iotool/laser-engraver/model-gcode/readme.md

# Model GCode

## Bilderrahmen Square von Depot

* 170x170mm-226x226px-round-corner-20mm.nc
* https://www.depot-online.de/de/p/bilderrahmen-square-22782
