iotool/laser-engraver/stencil/readme.md

# stencil font for laser cut

How to create a template for the Mini Laser Engraver.

## True Type Font

A special stencil font is required for cutting out the letters and numbers.
With a stencil font, all elements remain connected to the overall model via small bridges.

You can find free fonts on the Internet by searching for "free stencil font":
https://www.1001fonts.com/stenciled-fonts.html?page=3&items=10

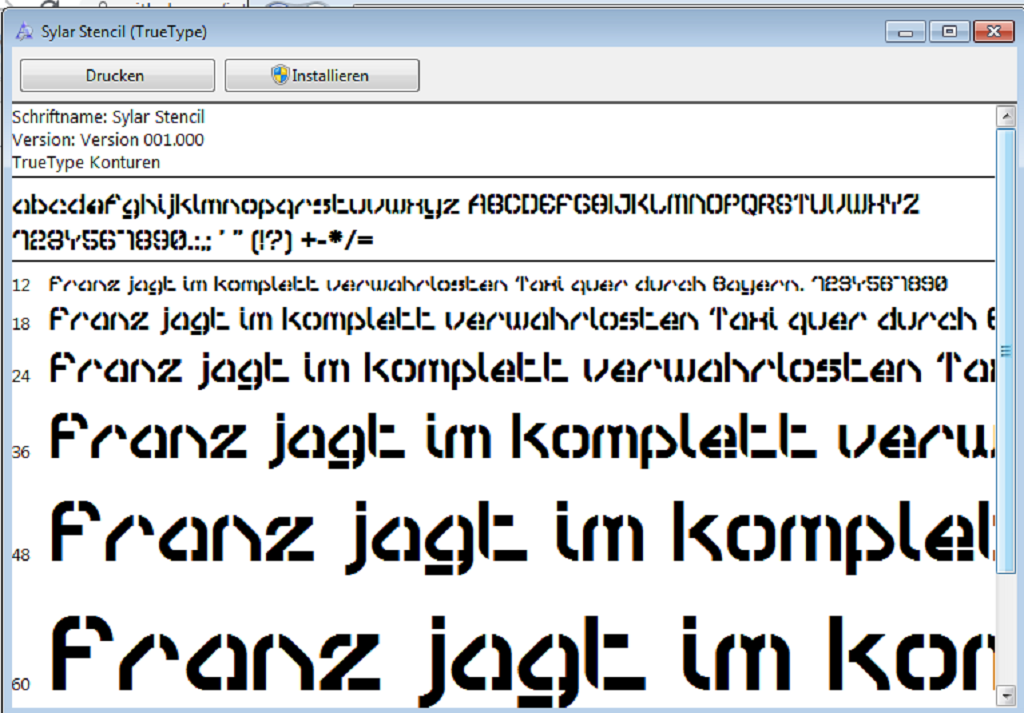
[picture p1: stencil/howto-0-stencil-font.png]
StencilFont


## Create 2D model

Only the outer edges may be cut for the Laser Cutter.
OpenSCAD can be used to determine the outer edges of text and graphics. 

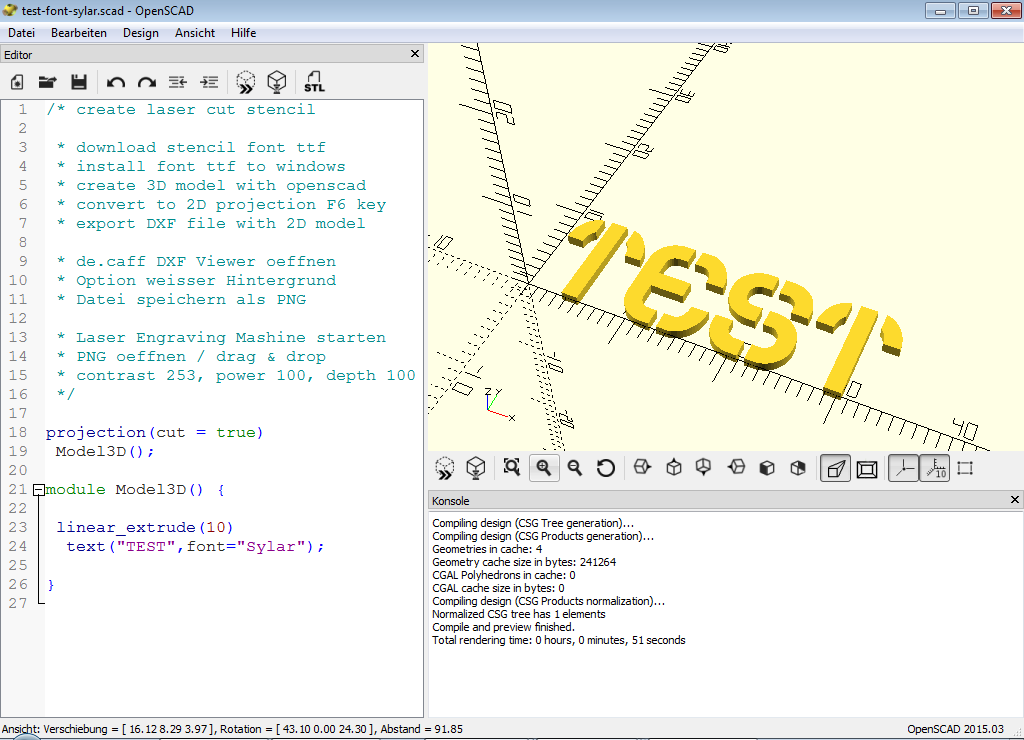
[picture p2: stencil/howto-1-openscad-3d.png]
OpenSCAD-3D


The result is exported in DXF file format.

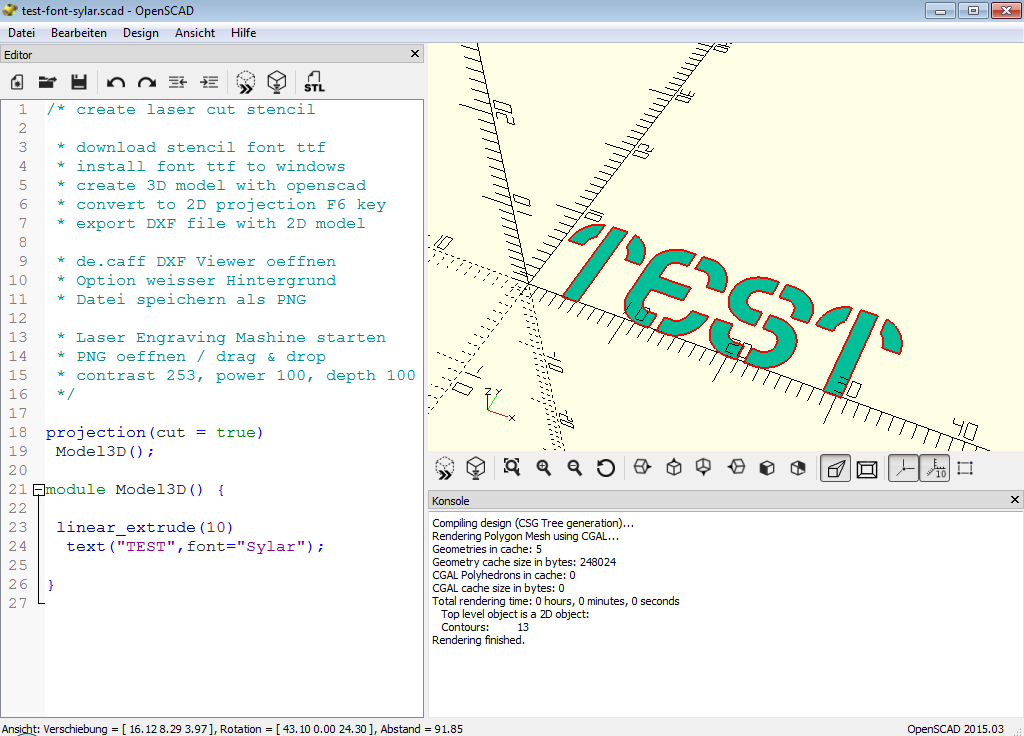
[picture p3: stencil/howto-2-openscad-2d.png]
OpenSCAD-2D


## Convert DXF to PNG

The DXF format describes the outer edges for the Laser Cutter.
For the cheap Laser Engraver DXF must be converted to PNG.

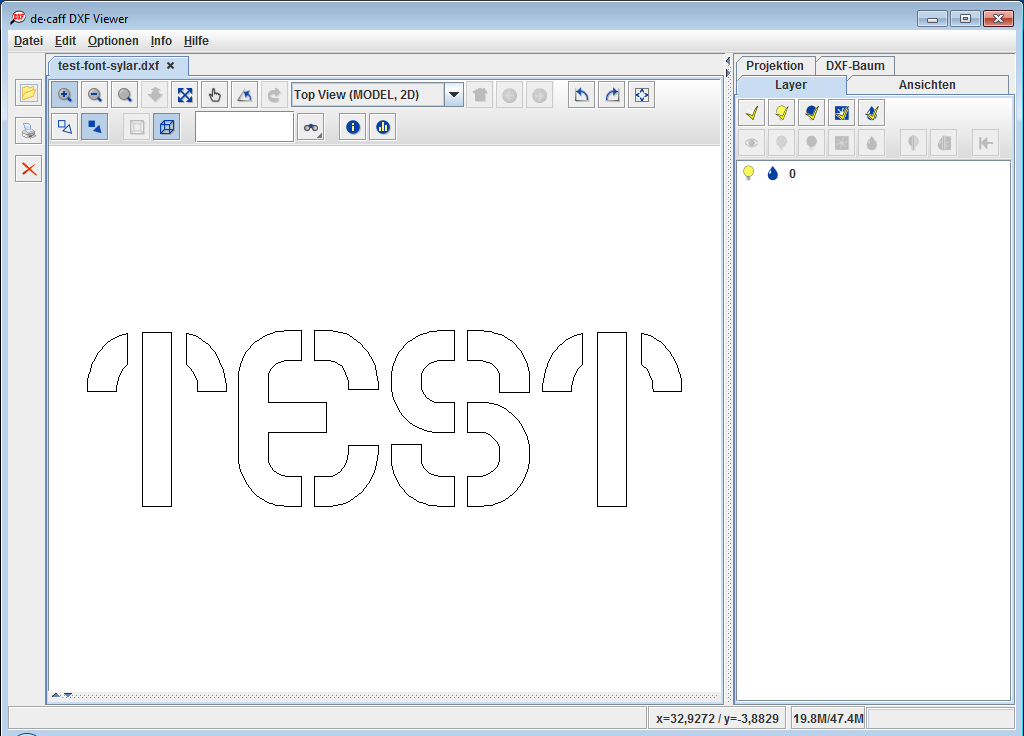
[picture p4: stencil/howto-3-decaff-dxfviewer.png]
DXF-Viewer


## Laser cut

Cutting from paper or foam rubber requires maximum power and contrast.

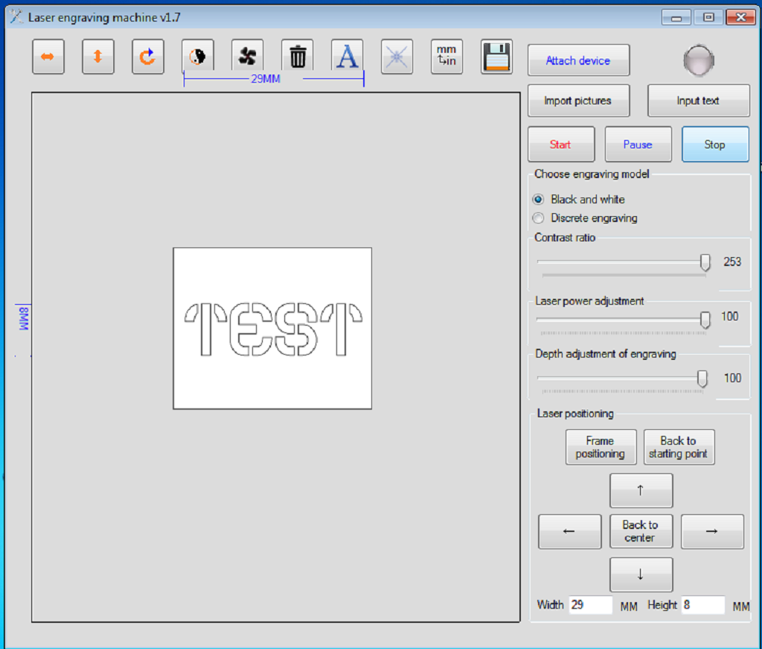
[picture p5: stencil/howto-4-laser-engraving-mashine.png]
LaserCut

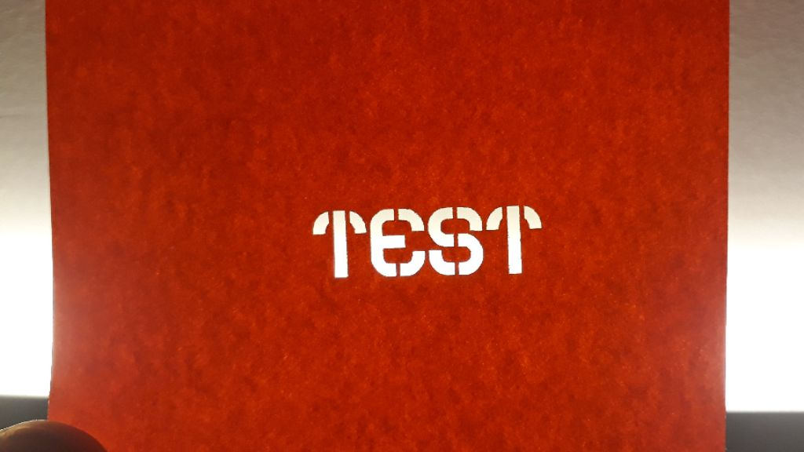
[picture p6: stencil/howto-5-stencil-paper.jpg]
StencilPaper


## Stencil Fonts

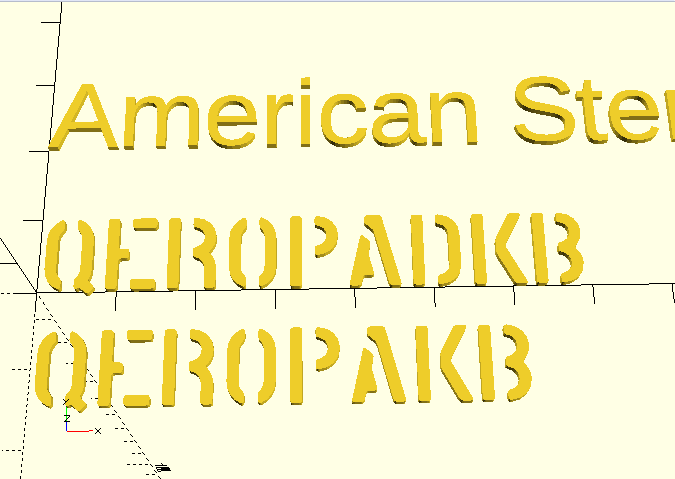
[picture p7: stencil/font-americanstencil.png]

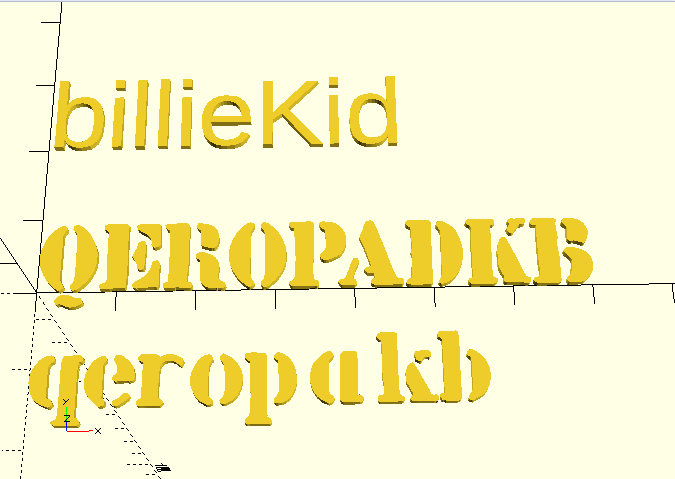
[picture p8: stencil/font-billiekid.png]

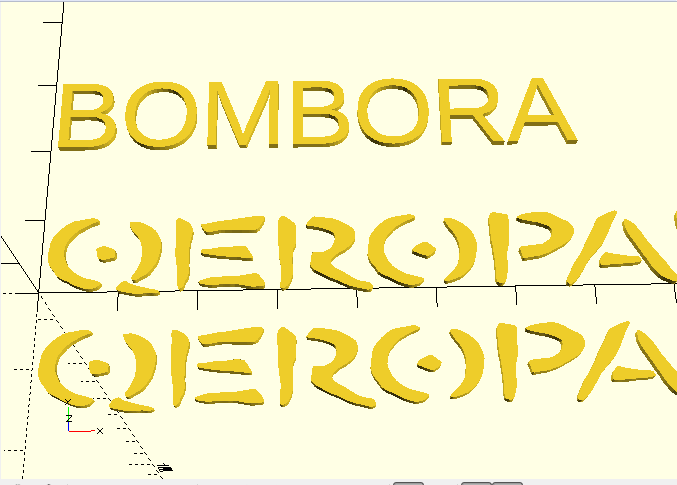
[picture p9: stencil/font-bombora.png]

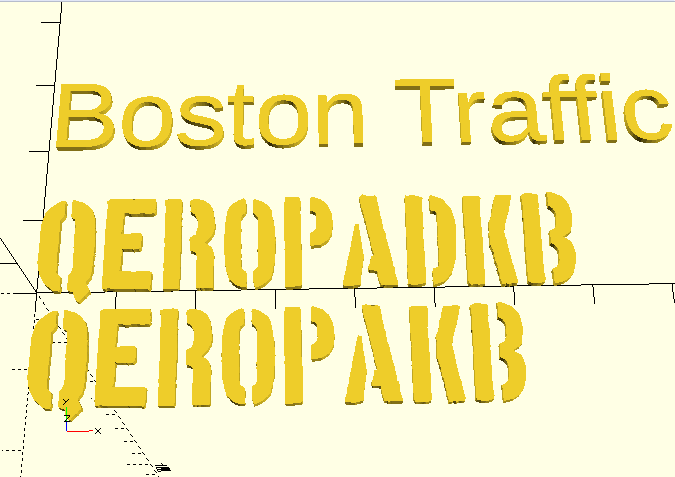
[picture p10: stencil/font-bostontraffic.png]

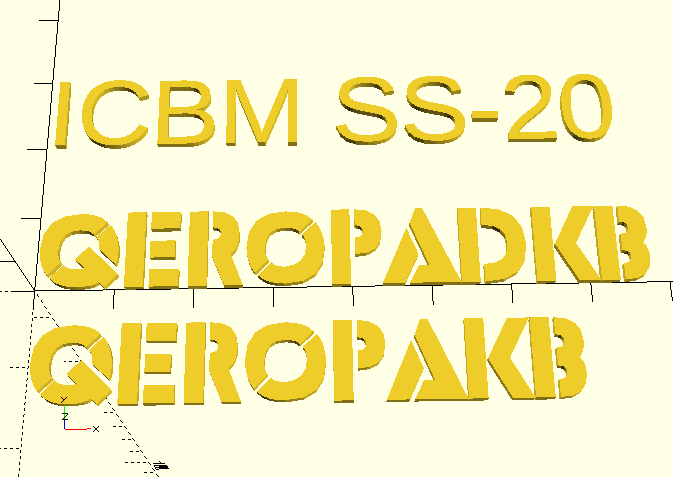
[picture p11: stencil/font-icbmss20.png]

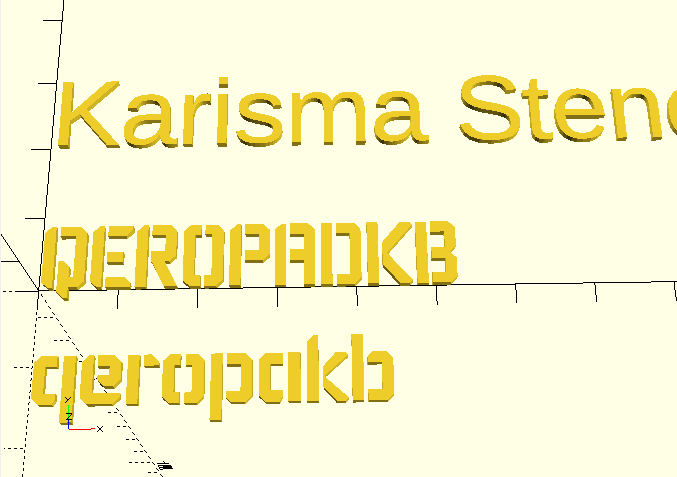
[picture p12: stencil/font-karismastencil.png]

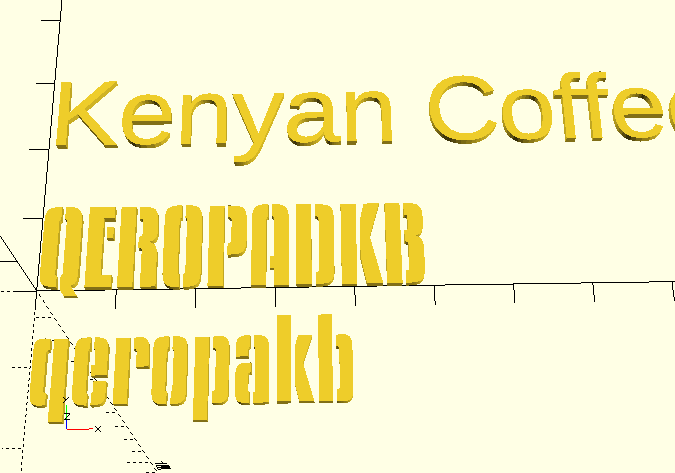
[picture p13: stencil/font-kenyancoffee.png]

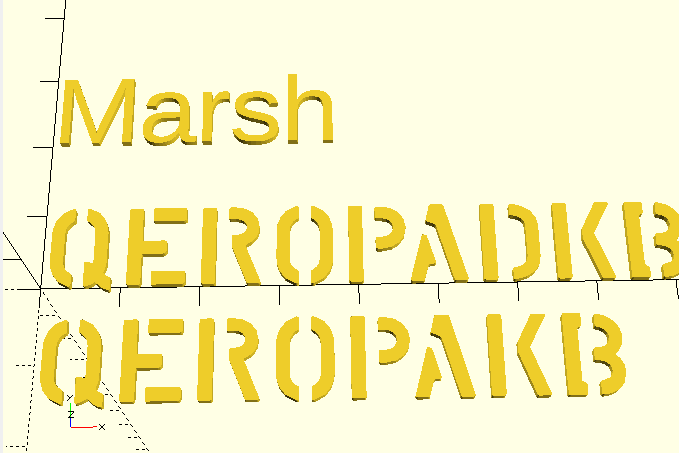
[picture p14: stencil/font-marsh.png]

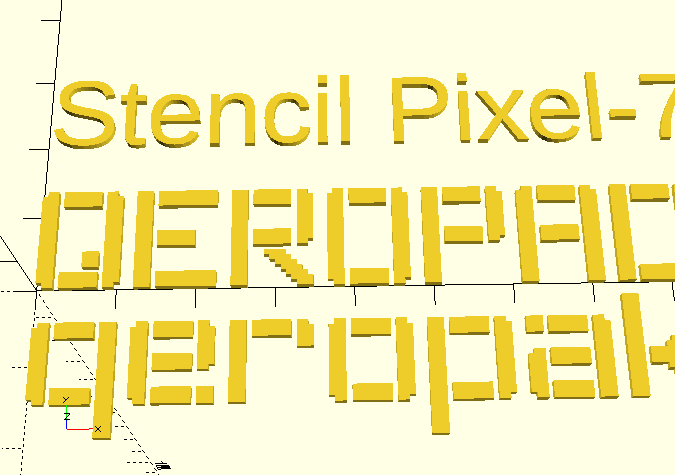
[picture p15: stencil/font-pixel7.png]

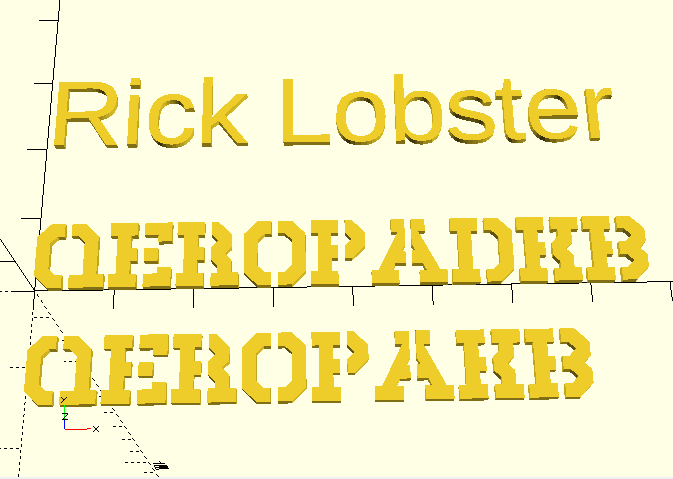
[picture p16: stencil/font-ricklobster.png]

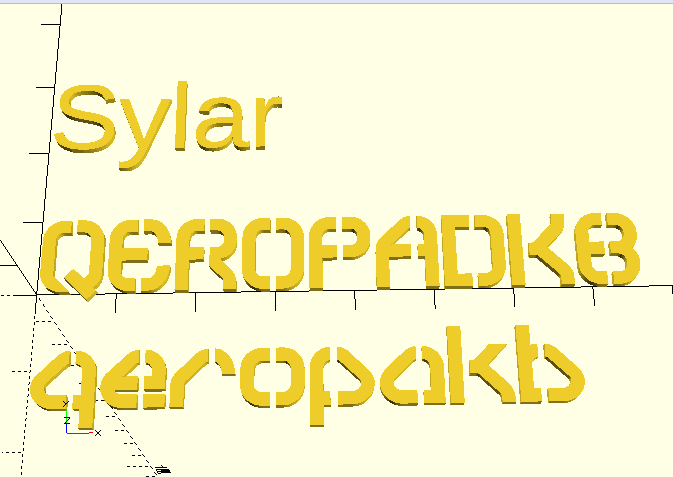
[picture p17: stencil/font-sylar.png]

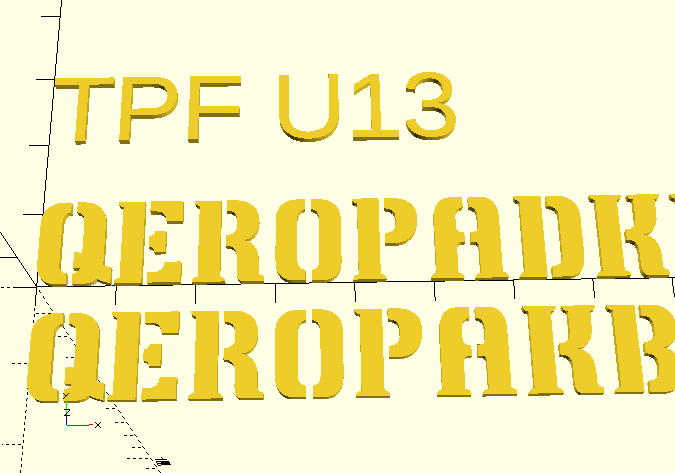
[picture p18: stencil/font-tpfu13.png]

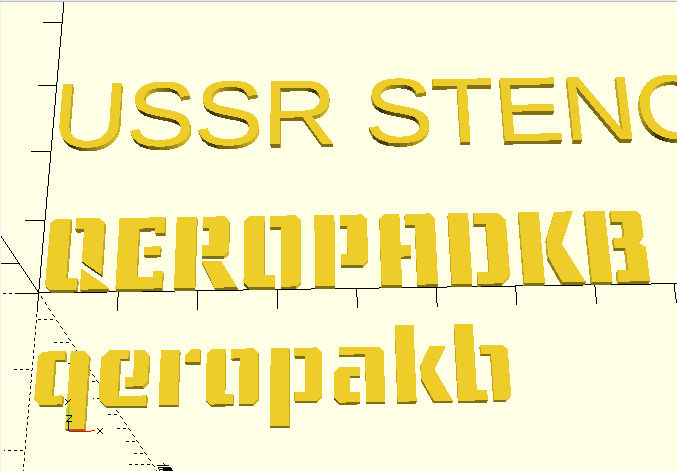
[picture p19: stencil/font-ussrstencil.png]

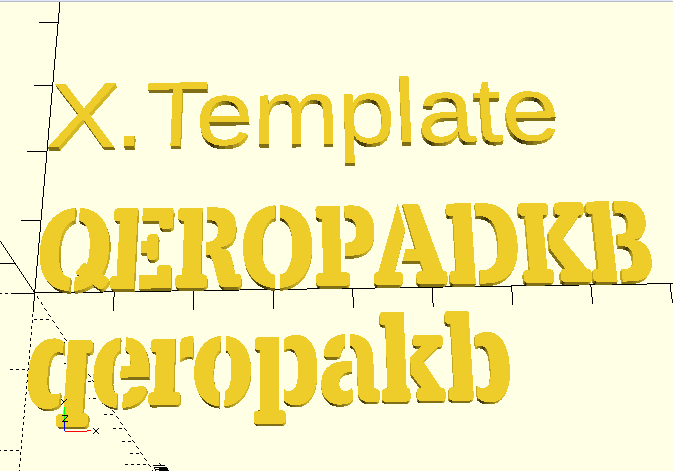
[picture p20: stencil/font-xtemplate.png]
