iotool/laser-engraver/neje-master-2/inkscape092-plugin-gcode/readme.md

# Inkscape 0.92 GCode Plugin (Laserengraver)

* copy to InkscapePortable0924\App\Inkscape\share\extensions
* create path > path from object or bitmap
* extension > laserengraver > laser
* save as c:\output\lasercut.nc

## Lasertools (linear infill)

Based on https://github.com/ChrisWag91/Inkscape-Lasertools-Plugin

This extension can generate CNC code for filled areas. This only works for paths with lines and not for curves.

Workaround for text:

* create text object
* path > object to path
* object > ungroup
* optional: path > simplify
* extension > modify path > flatten bezier (10)
* extension > lasertools > lasertools (0,2mm)

A good way to test the NC GCode is the CAMotics software.
