iotool/laser-engraver/neje-master-2/fan-holder/NejeMaster2-FanHolder-135x55mm.pdf

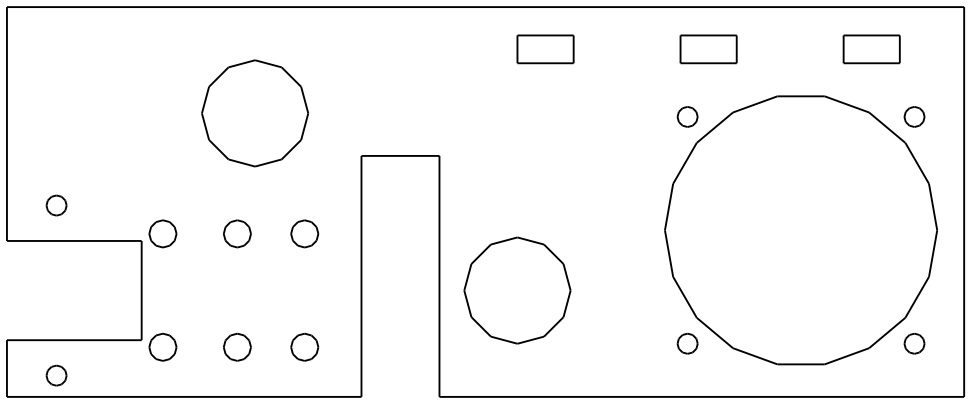
[picture p28: figure]

(0.0; 0.0; 0.0)
