iotool/laser-engraver/neje-master-2/fan-holder/NejeMaster2-FanHolder-135x50mm.pdf

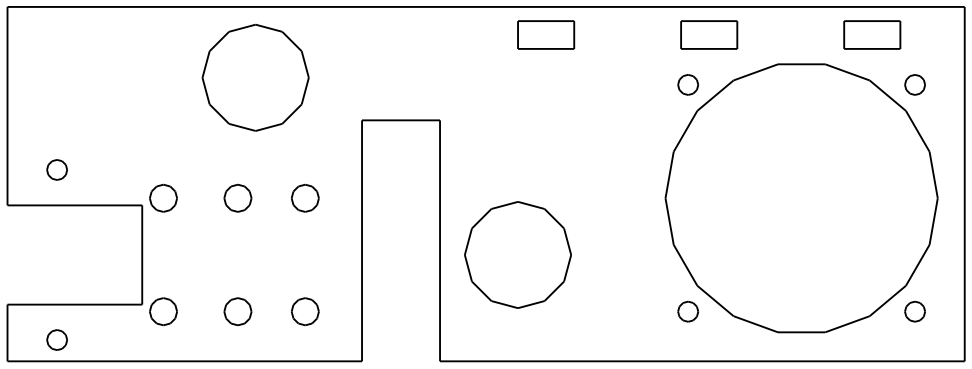
[picture p29: figure]
