iotool/laser-engraver/model-gcode/frame-170x170mm-226x226px-round-corner-20mm.png

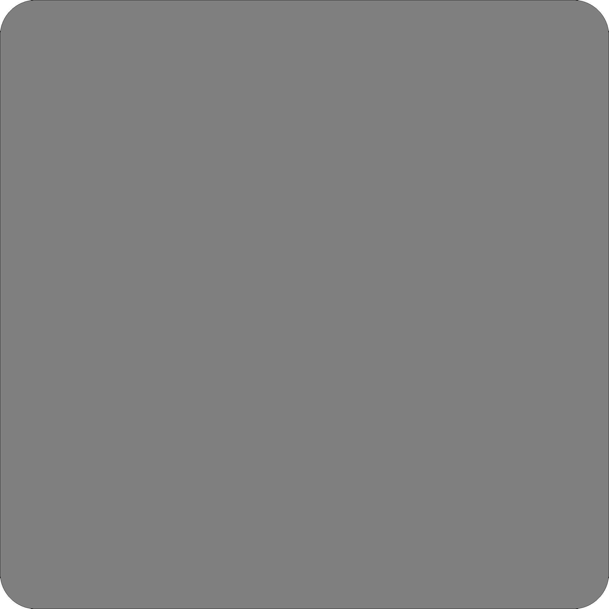
model-gcode/frame-170x170mm-226x226px-round-corner-20mm.png
