iotool/laser-engraver/neje-master-2/fan-holder/NejeMaster2-FanHolder-135x55mm.png

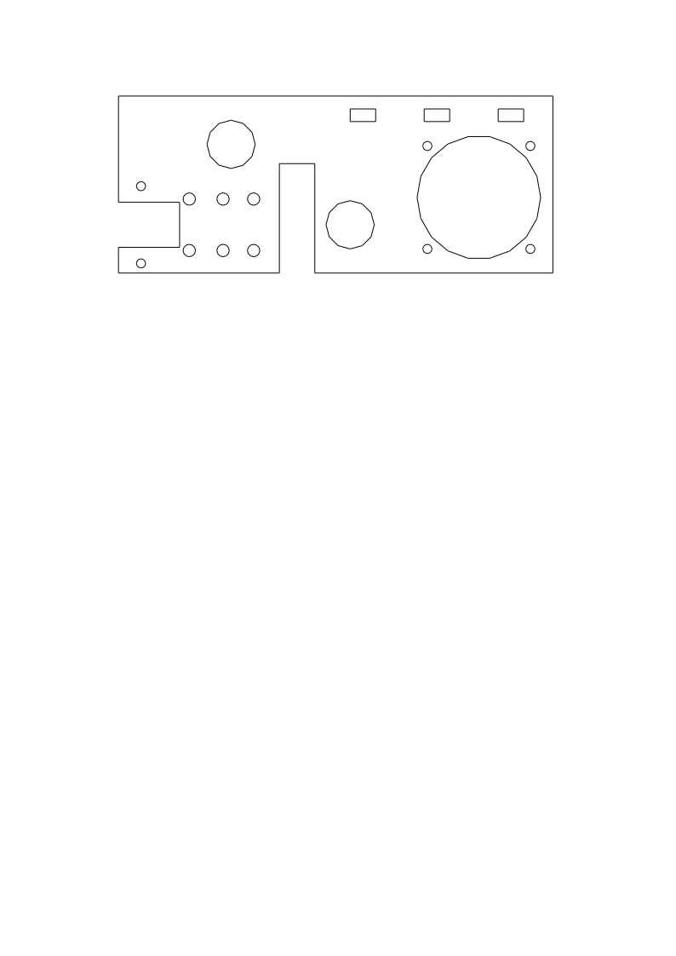
neje-master-2/fan-holder/NejeMaster2-FanHolder-135x55mm.png
