iotool/laser-engraver/model-scad/lasercut-boxes/lasercut-boxes-3mm-inside-147x123mm.dxf

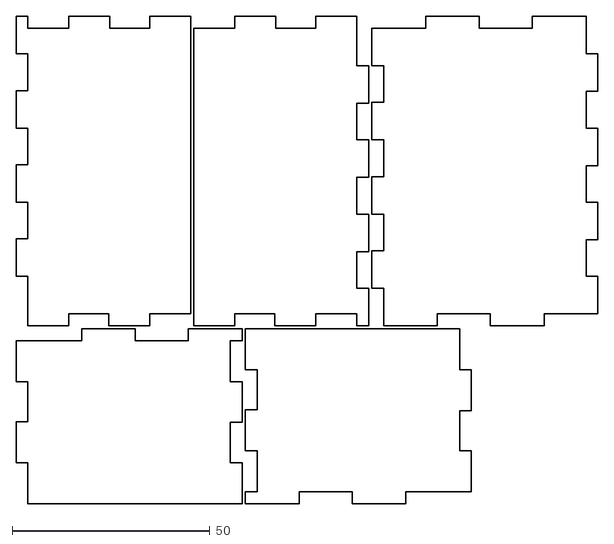
[picture p33: CAD file, 2020-11-06]
model-scad/lasercut-boxes/lasercut-boxes-3mm-inside-147x123mm.dxf
147.2 x 123.2
