iotool/laser-engraver/neje-master-2/fan-holder/NejeMaster2-FanHolder.stl

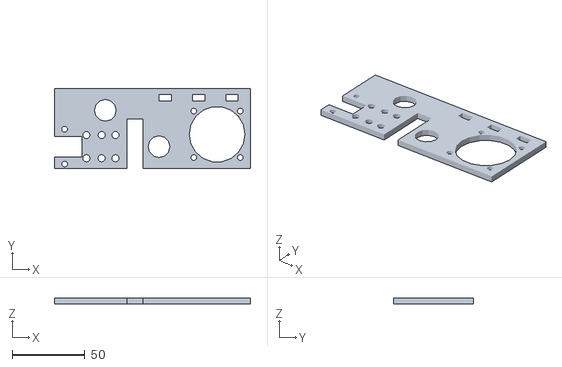
[picture p34: CAD file, 2020-10-24]
neje-master-2/fan-holder/NejeMaster2-FanHolder.stl
135.0 x 55.0 x 4.00
