iotool/laser-engraver/neje-master-2/test/test-speed-125x125mm.dxf

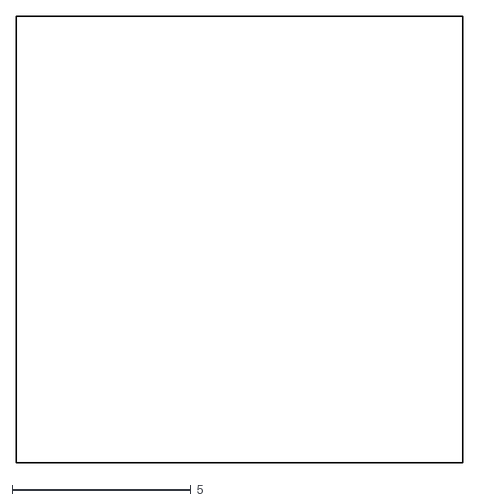
[picture p35: CAD file, 2020-10-25]
neje-master-2/test/test-speed-125x125mm.dxf
12.5 x 12.5
