iotool/laser-engraver/model-scad/lasercut-boxes/lasercut-boxes-3mm-outside-158x165mm.dxf

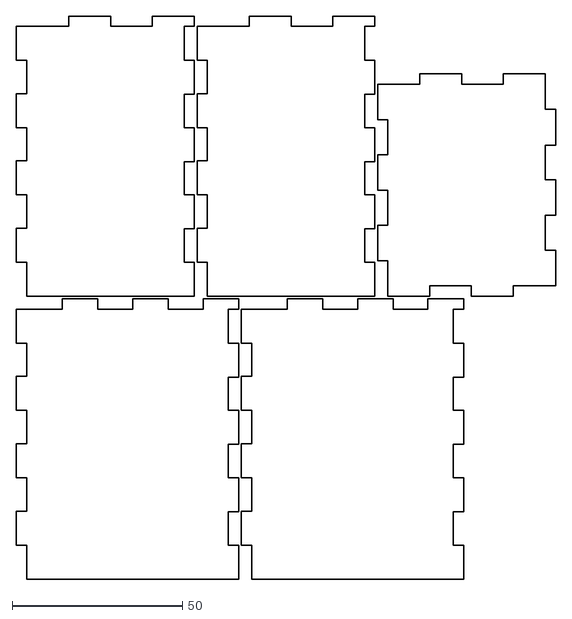
[picture p36: CAD file, 2020-11-06]
model-scad/lasercut-boxes/lasercut-boxes-3mm-outside-158x165mm.dxf
158.2 x 165.2
