iotool/laser-engraver/model-scad/lasercut-boxes/lasercut-boxes-4mm-inside-147x123mm.dxf

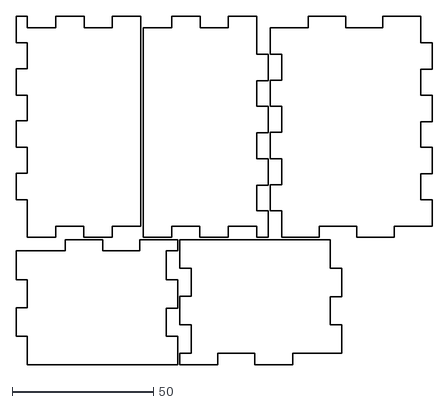
[picture p37: CAD file, 2020-11-06]
model-scad/lasercut-boxes/lasercut-boxes-4mm-inside-147x123mm.dxf
147.2 x 123.2
