iotool/laser-engraver/model-scad/lasercut-boxes/lasercut-boxes-4mm-outside-164x167mm.dxf

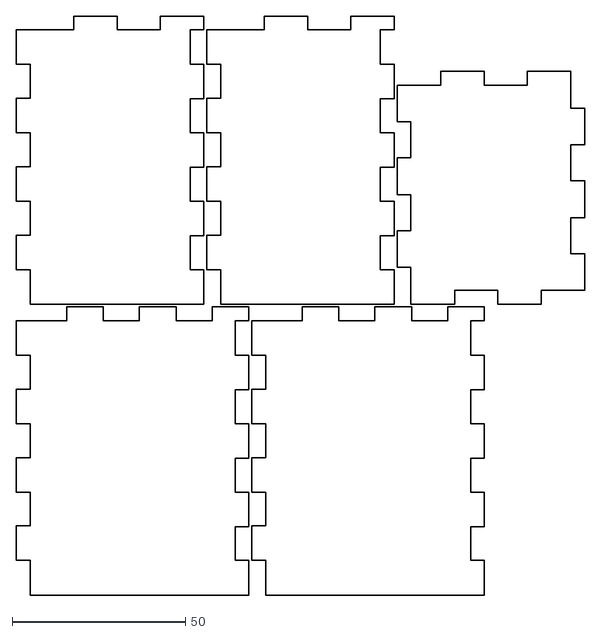
[picture p38: CAD file, 2020-11-06]
model-scad/lasercut-boxes/lasercut-boxes-4mm-outside-164x167mm.dxf
164.2 x 167.2
