iotool/laser-engraver/neje-master-2/test/test-speed-125x125mm.scad

projection()
cube([12.5,12.5,1]);
