iotool/laser-engraver/(list of files, cad)

Other CAD files:
stencil/stencil-test-font-sylar.dxf
model-scad/lasercut-util/lasercut-util.scad
neje-master-2/fan-holder/NejeMaster2-FanHolder.dxf
