iotool/laser-engraver/neje-master-2/test/readme.md

# NEJE Master 2

* Size max. 170 x 170 mm 
* Image max. 2266 x 2266 px
* 338 dpi (133.3 px/cm)
* reduce smoky smell with coffee powder

## Speed Test

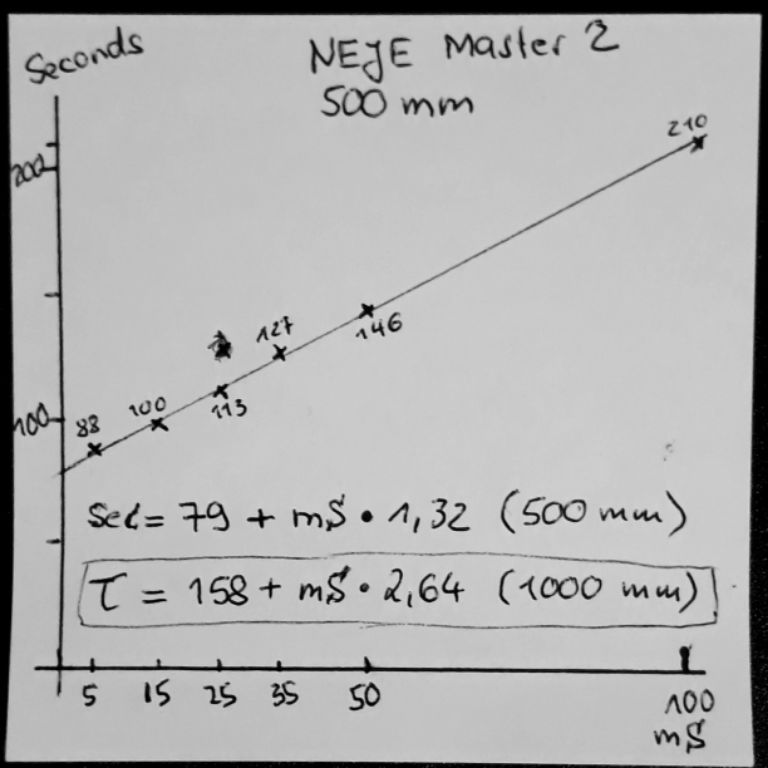
[picture p39: neje-master-2/test/test-speed-125x125mm.jpg]


My tests for a 500 mm laser cut show a correlation between burning time in mS and total processing time in seconds.

A double burning time in mS does not double the total duration in NEJE software!

Laser cutting of plywood with 25 mS burning time and 6 passes takes 678 seconds in total, but with 50 mS and 3 passes only 438 seconds.

NEJE recommendations: power 100% / burning time ...
* 20 ms = leather
* 30 ms = wood, bambo
* 30 ms = acrylic, bone, paint metal
* 40 ms = plastic
* 50 ms = rubber

## Test engrave playwood

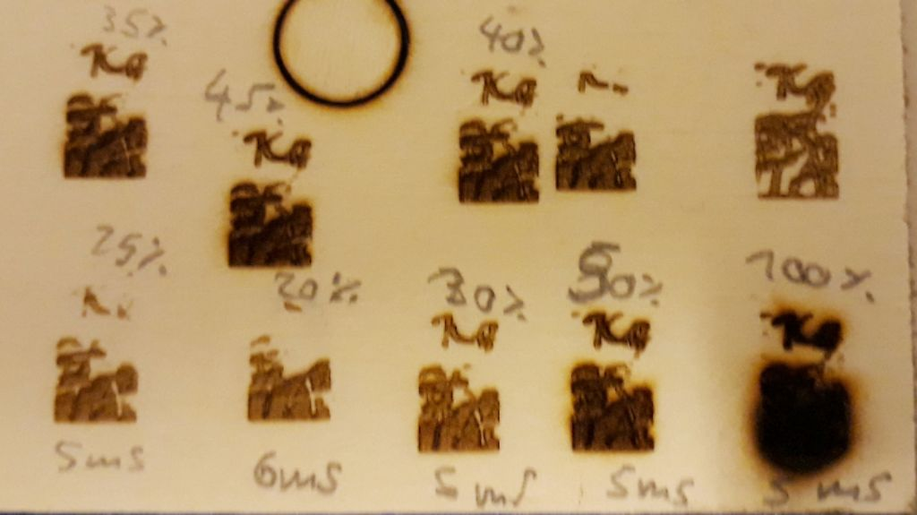
[picture p40: neje-master-2/test/test-engeave-playwood-5ms.jpg]


* burning time 5ms, power 30% - light
* burning time 5ms, power 40% - good
* burning time 5ms, power 50% - dark
* engraving speed = 97 seconds / cm

Not tested burning time 4ms, power 70%

## Paper 

* carving time 5ms / laser power 80% = cut
* carving time 5ms / laser power 60% = engrave
* carving time 2ms / laser power 100% = nothing

## Poplar Plywood (Pappel)

lightest European hardwood; very soft; low durability

2.8 mm / 3 layers / soft
* carving time 15ms / laser power 100% / 2x loops = partly cut
* carving time 15ms / laser power 100% / 3x loops = cut
* carving time 45ms / laser power 100% / 1x loop = cut

Clean cut and low burn marks at 45ms burning time and 2 passes.

## Gabon Plywood (Gabun-Pappel-Gabun)

African wood Okoumé (also: Gabon); moderately durable

3.8 mm / 3 layers / strong
* carving time 15ms / laser power 100% / 6x loops = partly cut
* carving time 15ms / laser power 100% / 7x loops = cut

Clean cut and low burn marks at 15ms burning time and 7 passes.

## Birch Plywood (Birke)

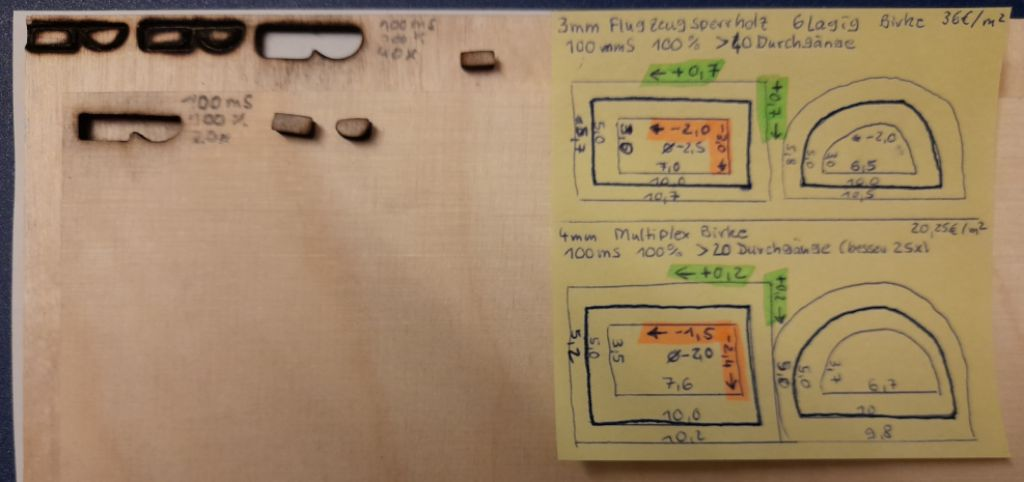
[picture p41: neje-master-2/test/birch-birke-3mm6x-4mm3x.jpg]


Finer grained, heavier and tougher wood, little weatherproof

3.0 mm / 6 layers / super strong (airplane plywood)
* carving time 100ms / laser power 100% / 38x loops = partly cut
* carving time 100ms / laser power 100% / 40x loops = cut
* -2.5 mm inside dimension (+2.7mm oversize)
* +0.7 mm outside dimension (-0.9mm shriksize)

4.0 mm / 3 layers / strong
* carving time 100ms / laser power 100% / 20x loops = partly cut
* carving time 100ms / laser power 100% / 22x loops = cut
* -2.0 mm inside dimension (+2.2mm oversize)
* +0.2 mm outside dimension (-0.4mm shriksize)

Unclean cut and burn marks at 100ms burning time and 20/40 passes. Reworking with grinding necessary and very slow.

## Acryl / Plexiglas

* good = PMMA (Polymethylmethacrylat)
* very good = PMMA "XT" (extrudiert)
* semi good = PMMA "GS" (gegossen) Toleranze 
* bad = PE (Polyethylene) verformte Kanten
* bad = Polystyrol
* never = PVC (Polyvinylchlorid) Chlor + Salzsäure

3mm Acrylic (test tbd)

* black: carving time 2mm/s, laser power 100%, 3x loops, z -1.0mm = cut
* black: carving time 5mm/s, laser power 100%, 8x loops, z -1.0mm = cut
* orange: carving time 2mm/s, laser power 100%, 12x loops, z -1.0mm = cut
* green: carving time 2mm/s, laser power 100%, 16x loops, z -1.0mm = cut
* blue: carving time 2mm/s, laser power 100%, 16x loops, z -1.0mm = none
