iotool/laser-engraver/neje-master-2/test/160x160mm-2132x2132px.png

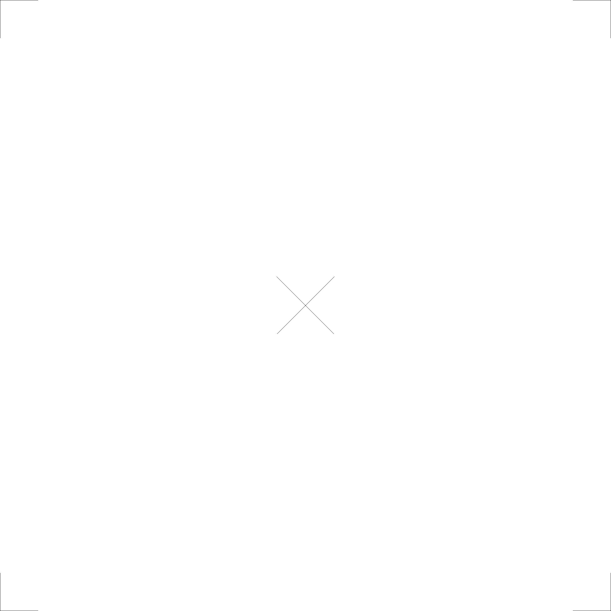
neje-master-2/test/160x160mm-2132x2132px.png
