iotool/laser-engraver/stencil/stencil-test-font-sylar.png

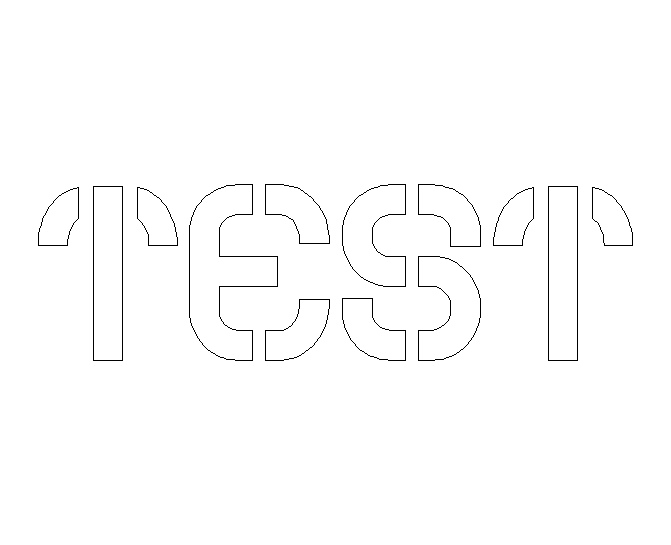
stencil/stencil-test-font-sylar.png
