iotool/laser-engraver/(commit log)

2020-10-24 fix fan posititon, reduce size
    [NejeMaster2-FanHolder.dxf, NejeMaster2-FanHolder.scad, NejeMaster2-FanHolder.stl]
2020-10-27 fix optional keyboard debug
    [NejeMaster2FanControlAttiny85.ino]
2020-10-28 reduce current consumption
2020-11-08 add inner joins
    [lasercut-boxes.scad]
